Ramen5914/KiCadFiles/3dmodels/RamenKeebs.models/ATMEGA32U4-AUR.step

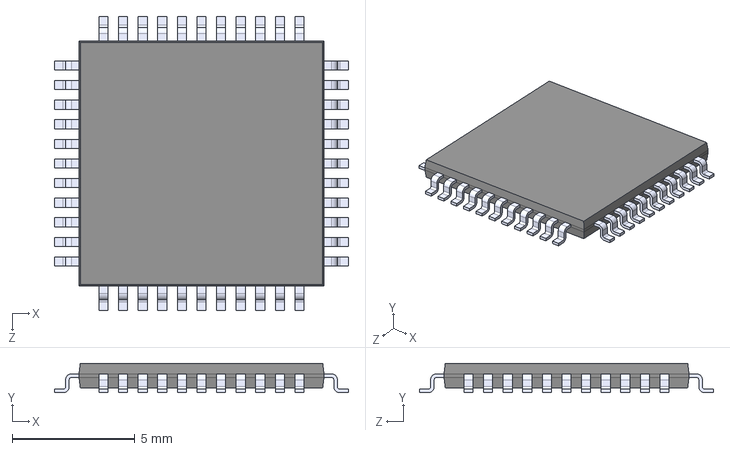
[picture p1: CAD file, 2022-03-06]
3dmodels/RamenKeebs.models/ATMEGA32U4-AUR.step
12.0 x 1.20 x 12.0 mm
