Ramen5914/KiCadFiles/3dmodels/RamenKeebs.models/USB4505-03-0-A.stp

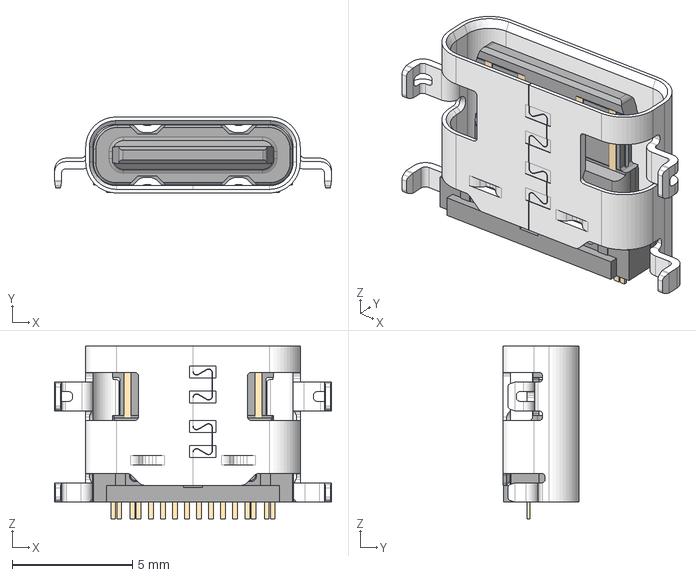
[picture p2: CAD file, 2022-03-06]
3dmodels/RamenKeebs.models/USB4505-03-0-A.stp
11.5 x 3.16 x 7.20 mm
Imported1
Cut-Extrude4
