Ramen5914/KiCadFiles/3dmodels/RamenKeebs.models/QBLP677R-RGB.step

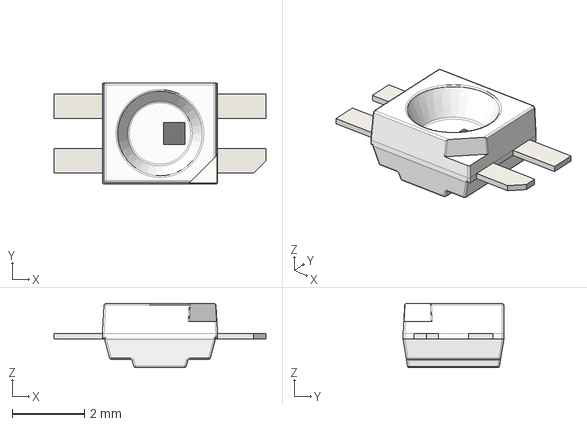
[picture p3: CAD file, 2022-03-06]
3dmodels/RamenKeebs.models/QBLP677R-RGB.step
5.88 x 2.80 x 1.78 mm
