Ramen5914/KiCadFiles/3dmodels/RamenKeebs.models/KAILH_PLATEMOUNT.step

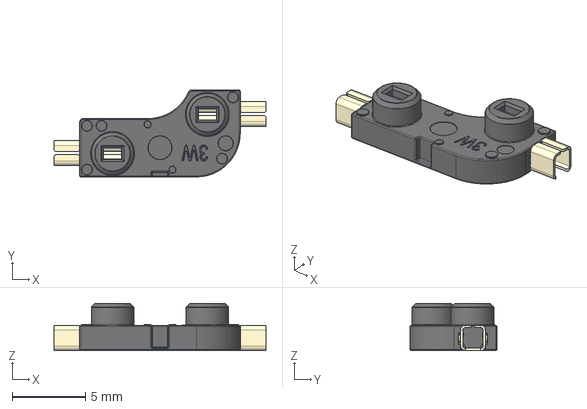
[picture p4: CAD file, 2022-03-06]
3dmodels/RamenKeebs.models/KAILH_PLATEMOUNT.step
14.5 x 5.95 x 3.22 mm
