Ramen5914/KiCadFiles/3dmodels/RamenKeebs.models/D_AXIAL.step

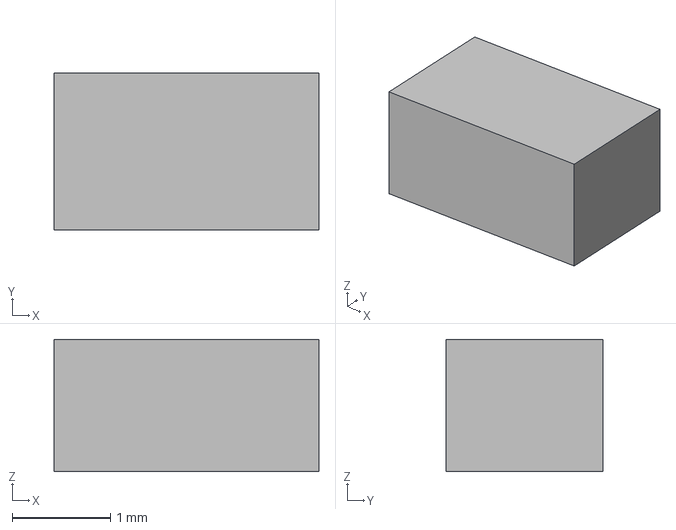
[picture p5: CAD file, 2022-02-28]
3dmodels/RamenKeebs.models/D_AXIAL.step
2.70 x 1.60 x 1.35 mm
