Ramen5914/KiCadFiles/(list of files, drawings)

Other design files:
projects/Ramen80/Ramen Board.dsn
