Ramen5914/KiCadFiles/projects/Ramen80/Ramen80.kicad_pcb

## KiCad design projects/Ramen80/Ramen80.kicad_pcb (2022-03-06)

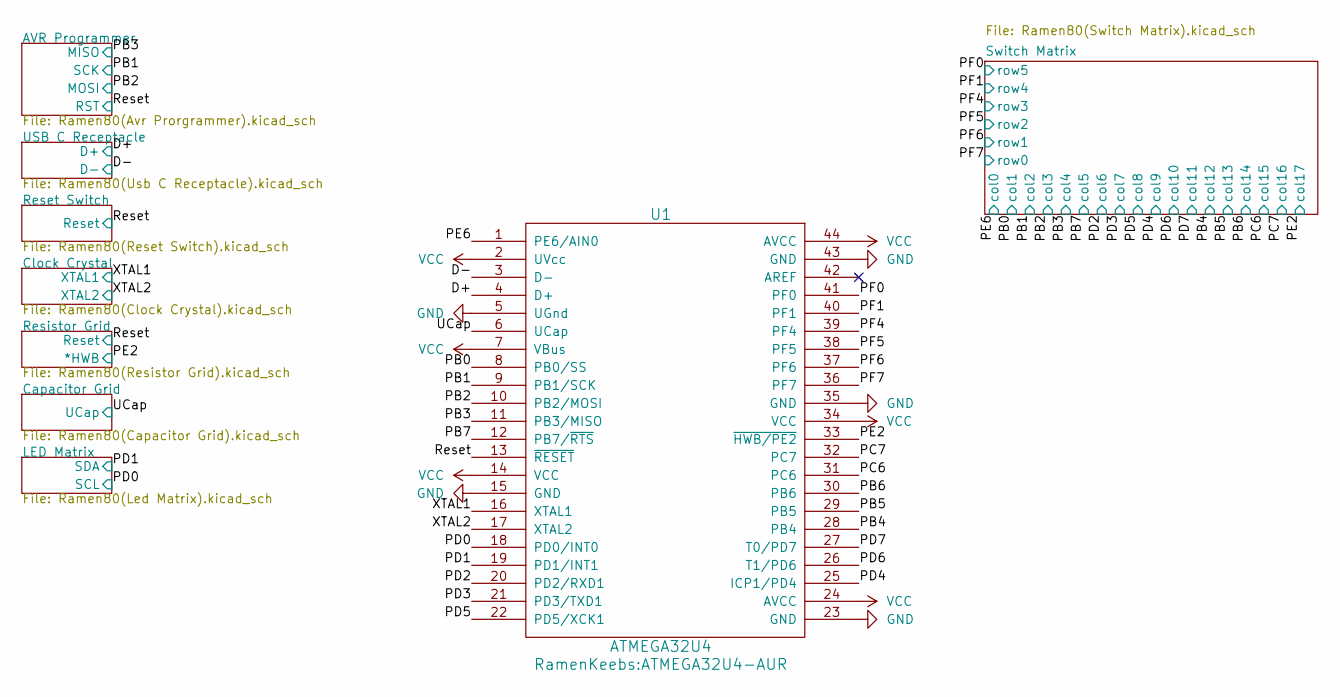
[picture p6: schematic Ramen80.kicad_sch]

Parts:
U1: ATMEGA32U4; ATMEGA32U4-AUR

Connections:
/D+: U1.4 (D+); also elsewhere on the board
/D-: U1.3 (D-); also elsewhere on the board
/PB0: U1.8 (PB0/SS); also elsewhere on the board
/PB1: U1.9 (PB1/SCK); also elsewhere on the board
/PB2: U1.10 (PB2/MOSI); also elsewhere on the board
/PB3: U1.11 (PB3/MISO); also elsewhere on the board
/PB4: U1.28 (PB4); also elsewhere on the board
/PB5: U1.29 (PB5); also elsewhere on the board
/PB6: U1.30 (PB6); also elsewhere on the board
/PB7: U1.12 (PB7/~RTS); also elsewhere on the board
/PC6: U1.31 (PC6); also elsewhere on the board
/PC7: U1.32 (PC7); also elsewhere on the board
/PD0: U1.18 (PD0/INT0); also elsewhere on the board
/PD1: U1.19 (PD1/INT1); also elsewhere on the board
/PD2: U1.20 (PD2/RXD1); also elsewhere on the board
/PD3: U1.21 (PD3/TXD1); also elsewhere on the board
/PD4: U1.25 (ICP1/PD4); also elsewhere on the board
/PD5: U1.22 (PD5/XCK1); also elsewhere on the board
/PD6: U1.26 (T1/PD6); also elsewhere on the board
/PD7: U1.27 (T0/PD7); also elsewhere on the board
/PE2: U1.33 (~HWB/PE2); also elsewhere on the board
/PE6: U1.1 (PE6/AIN0); also elsewhere on the board
/PF0: U1.41 (PF0); also elsewhere on the board
/PF1: U1.40 (PF1); also elsewhere on the board
/PF4: U1.39 (PF4); also elsewhere on the board
/PF5: U1.38 (PF5); also elsewhere on the board
/PF6: U1.37 (PF6); also elsewhere on the board
/PF7: U1.36 (PF7); also elsewhere on the board
/Reset: U1.13 (~RESET); also elsewhere on the board
/UCap: U1.6 (UCap); also elsewhere on the board
/XTAL1: U1.16 (XTAL1); also elsewhere on the board
/XTAL2: U1.17 (XTAL2); also elsewhere on the board
GND: U1.5 (UGnd), U1.15 (GND), U1.23 (GND), U1.35 (GND), U1.43 (GND); also elsewhere on the board
VCC: U1.2 (UVcc), U1.7 (VBus), U1.14 (VCC), U1.24 (AVCC), U1.34 (VCC), U1.44 (AVCC); also elsewhere on the board

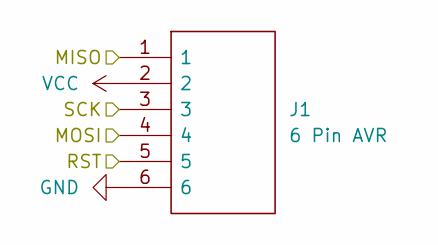
[picture p7: schematic Ramen80(Avr Prorgrammer).kicad_sch, Ramen80]

Parts:
J1: 6 Pin AVR; RHDR6W30P0X100_1X6_650X150X210P

Connections:
/PB1: J1.3; also elsewhere on the board
/PB2: J1.4; also elsewhere on the board
/PB3: J1.1; also elsewhere on the board
/Reset: J1.5; also elsewhere on the board
GND: J1.6; also elsewhere on the board
VCC: J1.2; also elsewhere on the board

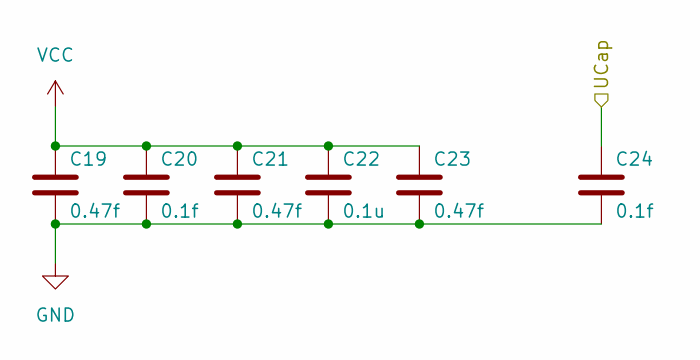
[picture p8: schematic Ramen80(Capacitor Grid).kicad_sch, Ramen80]

Parts:
C19, C21, C23: 0.47f; C_0805
C20, C24: 0.1f; C_0805
C22: 0.1u; C_0805

Connections:
/UCap: C24.1; also elsewhere on the board
GND: C19.2, C20.2, C21.2, C22.2, C23.2, C24.2; also elsewhere on the board
VCC: C19.1, C20.1, C21.1, C22.1, C23.1; also elsewhere on the board

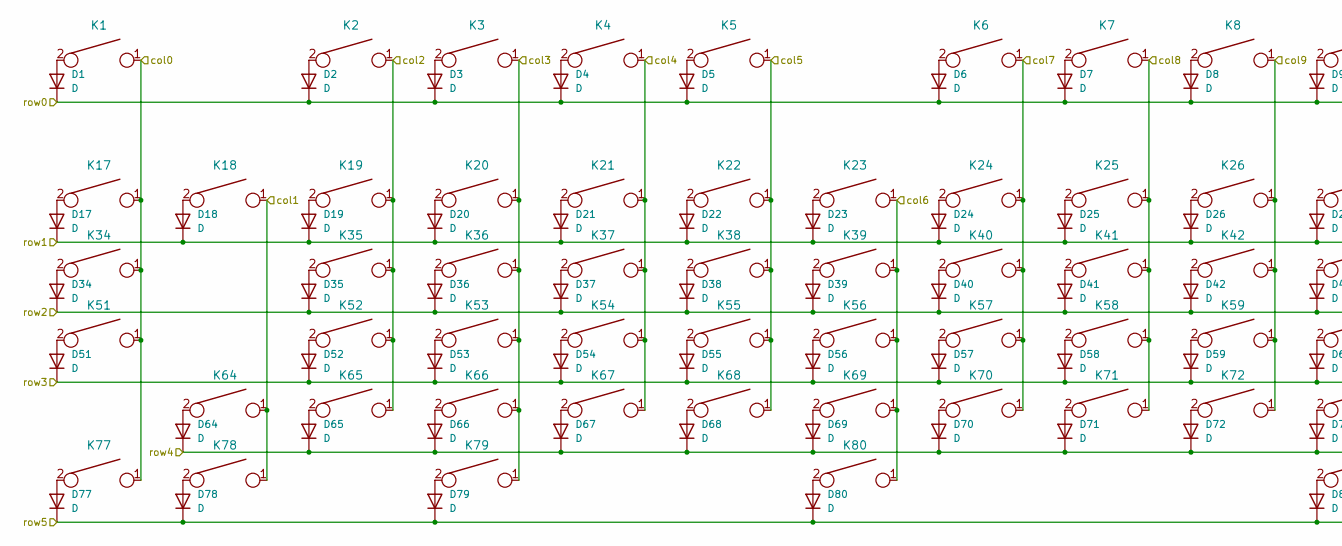
[picture p9: schematic Ramen80(Switch Matrix).kicad_sch, Ramen80, part in row 1, column 1]

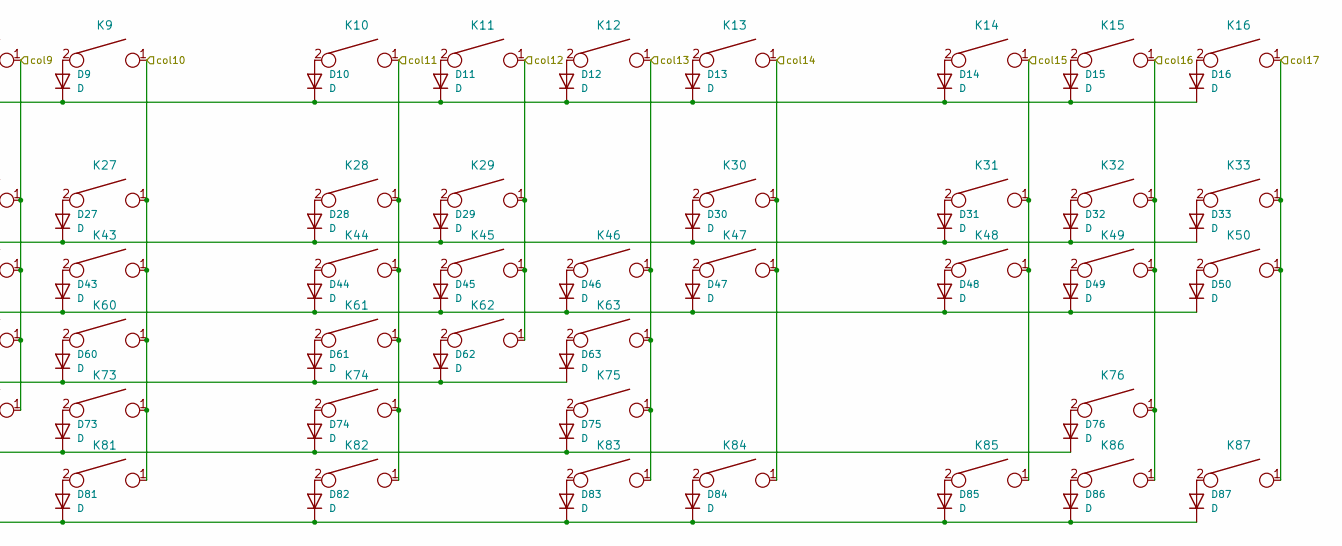
[picture p10: schematic Ramen80(Switch Matrix).kicad_sch, Ramen80, part in row 1, column 2]

Parts:
D1, D2, D3, D4, D5, D6, D7, D8, D9, D10, D11, D12, D13, D14, D15, D16, D17, D18, D19, D20, D21, D22, D23, D24, D25, D26, D27, D28, D29, D30, D31, D32, D33, D34, D35, D36, D37, D38, D39, D40, D41, D42, D43, D44, D45, D46, D47, D48, D49, D50, D51, D52, D53, D54, D55, D56, D57, D58, D59, D60, D61, D62, D63, D64, D65, D66, D67, D68, D69, D70, D71, D72, D73, D74, D75, D76, D77, D78, D79, D80, D81, D82, D83, D84, D85, D86, D87: D; D_AXIAL
K1, K2, K3, K4, K5, K6, K7, K8, K9, K10, K11, K12, K13, K14, K15, K16, K17, K18, K19, K20, K21, K22, K23, K24, K25, K26, K27, K28, K29, K30, K31, K32, K33, K34, K35, K36, K37, K38, K39, K40, K41, K42, K43, K44, K45, K46, K47, K48, K49, K50, K51, K52, K53, K54, K55, K56, K57, K58, K59, K60, K61, K62, K63, K64, K65, K66, K67, K68, K69, K70, K71, K72, K73, K74, K75, K76, K77, K78, K79, K80, K81, K82, K83, K84, K85, K86, K87: KEYSW; KAILH_PLATEMOUNT

Connections:
/PB0: K18.1, K64.1, K78.1; also elsewhere on the board
/PB1: K2.1, K19.1, K35.1, K52.1, K65.1; also elsewhere on the board
/PB2: K3.1, K20.1, K36.1, K53.1, K66.1, K79.1; also elsewhere on the board
/PB3: K4.1, K21.1, K37.1, K54.1, K67.1; also elsewhere on the board
/PB4: K11.1, K29.1, K45.1, K62.1; also elsewhere on the board
/PB5: K12.1, K46.1, K63.1, K75.1, K83.1; also elsewhere on the board
/PB6: K13.1, K30.1, K47.1, K84.1; also elsewhere on the board
/PB7: K5.1, K22.1, K38.1, K55.1, K68.1; also elsewhere on the board
/PC6: K14.1, K31.1, K48.1, K85.1; also elsewhere on the board
/PC7: K15.1, K32.1, K49.1, K76.1, K86.1; also elsewhere on the board
/PD2: K23.1, K39.1, K56.1, K69.1, K80.1; also elsewhere on the board
/PD3: K6.1, K24.1, K40.1, K57.1, K70.1; also elsewhere on the board
/PD4: K8.1, K26.1, K42.1, K59.1, K72.1; also elsewhere on the board
/PD5: K7.1, K25.1, K41.1, K58.1, K71.1; also elsewhere on the board
/PD6: K9.1, K27.1, K43.1, K60.1, K73.1, K81.1; also elsewhere on the board
/PD7: K10.1, K28.1, K44.1, K61.1, K74.1, K82.1; also elsewhere on the board
/PE2: K16.1, K33.1, K50.1, K87.1; also elsewhere on the board
/PE6: K1.1, K17.1, K34.1, K51.1, K77.1; also elsewhere on the board
/PF0: D77.1 (K), D78.1 (K), D79.1 (K), D80.1 (K), D81.1 (K), D82.1 (K), D83.1 (K), D84.1 (K), D85.1 (K), D86.1 (K), D87.1 (K); also elsewhere on the board
/PF1: D64.1 (K), D65.1 (K), D66.1 (K), D67.1 (K), D68.1 (K), D69.1 (K), D70.1 (K), D71.1 (K), D72.1 (K), D73.1 (K), D74.1 (K), D75.1 (K), D76.1 (K); also elsewhere on the board
/PF4: D51.1 (K), D52.1 (K), D53.1 (K), D54.1 (K), D55.1 (K), D56.1 (K), D57.1 (K), D58.1 (K), D59.1 (K), D60.1 (K), D61.1 (K), D62.1 (K), D63.1 (K); also elsewhere on the board
/PF5: D34.1 (K), D35.1 (K), D36.1 (K), D37.1 (K), D38.1 (K), D39.1 (K), D40.1 (K), D41.1 (K), D42.1 (K), D43.1 (K), D44.1 (K), D45.1 (K), D46.1 (K), D47.1 (K), D48.1 (K), D49.1 (K), D50.1 (K); also elsewhere on the board
/PF6: D17.1 (K), D18.1 (K), D19.1 (K), D20.1 (K), D21.1 (K), D22.1 (K), D23.1 (K), D24.1 (K), D25.1 (K), D26.1 (K), D27.1 (K), D28.1 (K), D29.1 (K), D30.1 (K), D31.1 (K), D32.1 (K), D33.1 (K); also elsewhere on the board
/PF7: D1.1 (K), D2.1 (K), D3.1 (K), D4.1 (K), D5.1 (K), D6.1 (K), D7.1 (K), D8.1 (K), D9.1 (K), D10.1 (K), D11.1 (K), D12.1 (K), D13.1 (K), D14.1 (K), D15.1 (K), D16.1 (K); also elsewhere on the board
unnamed: D1.2 (A), K1.2
unnamed: D2.2 (A), K2.2
unnamed: D3.2 (A), K3.2
unnamed: D4.2 (A), K4.2
unnamed: D5.2 (A), K5.2
unnamed: D6.2 (A), K6.2
unnamed: D7.2 (A), K7.2
unnamed: D8.2 (A), K8.2
unnamed: D9.2 (A), K9.2
unnamed: D10.2 (A), K10.2
unnamed: D11.2 (A), K11.2
unnamed: D12.2 (A), K12.2
unnamed: D13.2 (A), K13.2
unnamed: D14.2 (A), K14.2
unnamed: D15.2 (A), K15.2
unnamed: D16.2 (A), K16.2
unnamed: D17.2 (A), K17.2
unnamed: D18.2 (A), K18.2
unnamed: D19.2 (A), K19.2
unnamed: D20.2 (A), K20.2
unnamed: D21.2 (A), K21.2
unnamed: D22.2 (A), K22.2
unnamed: D23.2 (A), K23.2
unnamed: D24.2 (A), K24.2
unnamed: D25.2 (A), K25.2
unnamed: D26.2 (A), K26.2
unnamed: D27.2 (A), K27.2
unnamed: D28.2 (A), K28.2
unnamed: D29.2 (A), K29.2
unnamed: D30.2 (A), K30.2
unnamed: D31.2 (A), K31.2
unnamed: D32.2 (A), K32.2
unnamed: D33.2 (A), K33.2
unnamed: D34.2 (A), K34.2
unnamed: D35.2 (A), K35.2
unnamed: D36.2 (A), K36.2
unnamed: D37.2 (A), K37.2
unnamed: D38.2 (A), K38.2
unnamed: D39.2 (A), K39.2
unnamed: D40.2 (A), K40.2
unnamed: D41.2 (A), K41.2
unnamed: D42.2 (A), K42.2
unnamed: D43.2 (A), K43.2
unnamed: D44.2 (A), K44.2
unnamed: D45.2 (A), K45.2
unnamed: D46.2 (A), K46.2
unnamed: D47.2 (A), K47.2
unnamed: D48.2 (A), K48.2
unnamed: D49.2 (A), K49.2
unnamed: D50.2 (A), K50.2
unnamed: D51.2 (A), K51.2
unnamed: D52.2 (A), K52.2
unnamed: D53.2 (A), K53.2
unnamed: D54.2 (A), K54.2
unnamed: D55.2 (A), K55.2
unnamed: D56.2 (A), K56.2
unnamed: D57.2 (A), K57.2
unnamed: D58.2 (A), K58.2
unnamed: D59.2 (A), K59.2
unnamed: D60.2 (A), K60.2
unnamed: D61.2 (A), K61.2
unnamed: D62.2 (A), K62.2
unnamed: D63.2 (A), K63.2
unnamed: D64.2 (A), K64.2
unnamed: D65.2 (A), K65.2
unnamed: D66.2 (A), K66.2
unnamed: D67.2 (A), K67.2
unnamed: D68.2 (A), K68.2
unnamed: D69.2 (A), K69.2
unnamed: D70.2 (A), K70.2
unnamed: D71.2 (A), K71.2
unnamed: D72.2 (A), K72.2
unnamed: D73.2 (A), K73.2
unnamed: D74.2 (A), K74.2
unnamed: D75.2 (A), K75.2
unnamed: D76.2 (A), K76.2
unnamed: D77.2 (A), K77.2
unnamed: D78.2 (A), K78.2
unnamed: D79.2 (A), K79.2
unnamed: D80.2 (A), K80.2
unnamed: D81.2 (A), K81.2
unnamed: D82.2 (A), K82.2
unnamed: D83.2 (A), K83.2
unnamed: D84.2 (A), K84.2
unnamed: D85.2 (A), K85.2
unnamed: D86.2 (A), K86.2
unnamed: D87.2 (A), K87.2

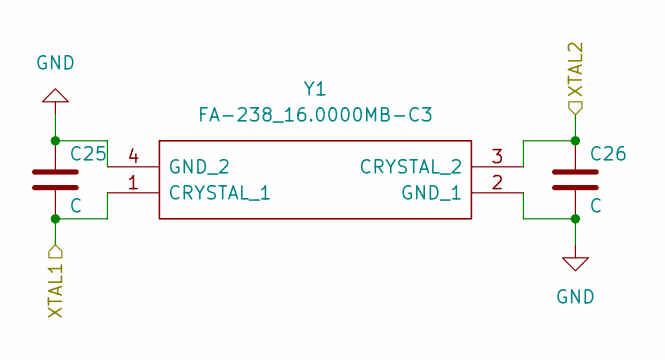
[picture p11: schematic Ramen80(Clock Crystal).kicad_sch, Ramen80]

Parts:
C25, C26: C; C_0805
Y1: FA-238_16.0000MB-C3; FA238160000MBC3; Manufacturer_Part_Number FA-238 16.0000MB-C3; Mouser Part Number 732-FA-23816B-C3

Connections:
/XTAL1: C25.2, Y1.1 (CRYSTAL_1); also elsewhere on the board
/XTAL2: C26.1, Y1.3 (CRYSTAL_2); also elsewhere on the board
GND: C25.1, C26.2, Y1.2 (GND_1), Y1.4 (GND_2); also elsewhere on the board

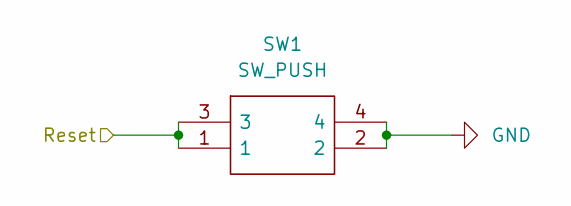
[picture p12: schematic Ramen80(Reset Switch).kicad_sch, Ramen80]

Parts:
SW1: SW_PUSH; TL3342F160QG

Connections:
/Reset: SW1.1, SW1.3; also elsewhere on the board
GND: SW1.2, SW1.4; also elsewhere on the board

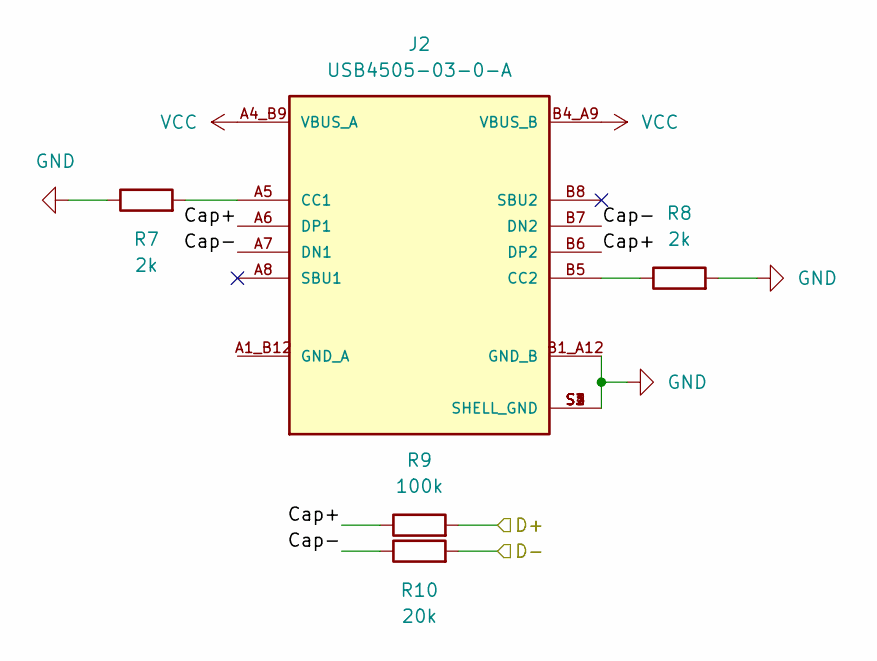
[picture p13: schematic Ramen80(Usb C Receptacle).kicad_sch, Ramen80]

Parts:
J2: USB4505-03-0-A
R7, R8: 2k; R_0805
R9: 100k; R_0805
R10: 20k; R_0805

Connections:
/D+: R9.2; also elsewhere on the board
/D-: R10.2; also elsewhere on the board
/USB C Receptacle/Cap+: J2.A6 (DP1), J2.B6 (DP2), R9.1
/USB C Receptacle/Cap-: J2.A7 (DN1), J2.B7 (DN2), R10.1
GND: J2.B1_A12 (GND_B), J2.S1 (SHELL_GND), J2.S2 (SHELL_GND), J2.S3 (SHELL_GND), J2.S4 (SHELL_GND), R7.1, R8.2; also elsewhere on the board
unnamed: J2.A5 (CC1), R7.2
unnamed: J2.B5 (CC2), R8.1
VCC: J2.A4_B9 (VBUS_A), J2.B4_A9 (VBUS_B); also elsewhere on the board

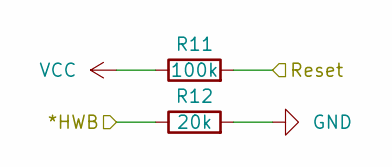
[picture p14: schematic Ramen80(Resistor Grid).kicad_sch, Ramen80]

Parts:
R11: 100k; R_0805
R12: 20k; R_0805

Connections:
/PE2: R12.1; also elsewhere on the board
/Reset: R11.2; also elsewhere on the board
GND: R12.2; also elsewhere on the board
VCC: R11.1; also elsewhere on the board

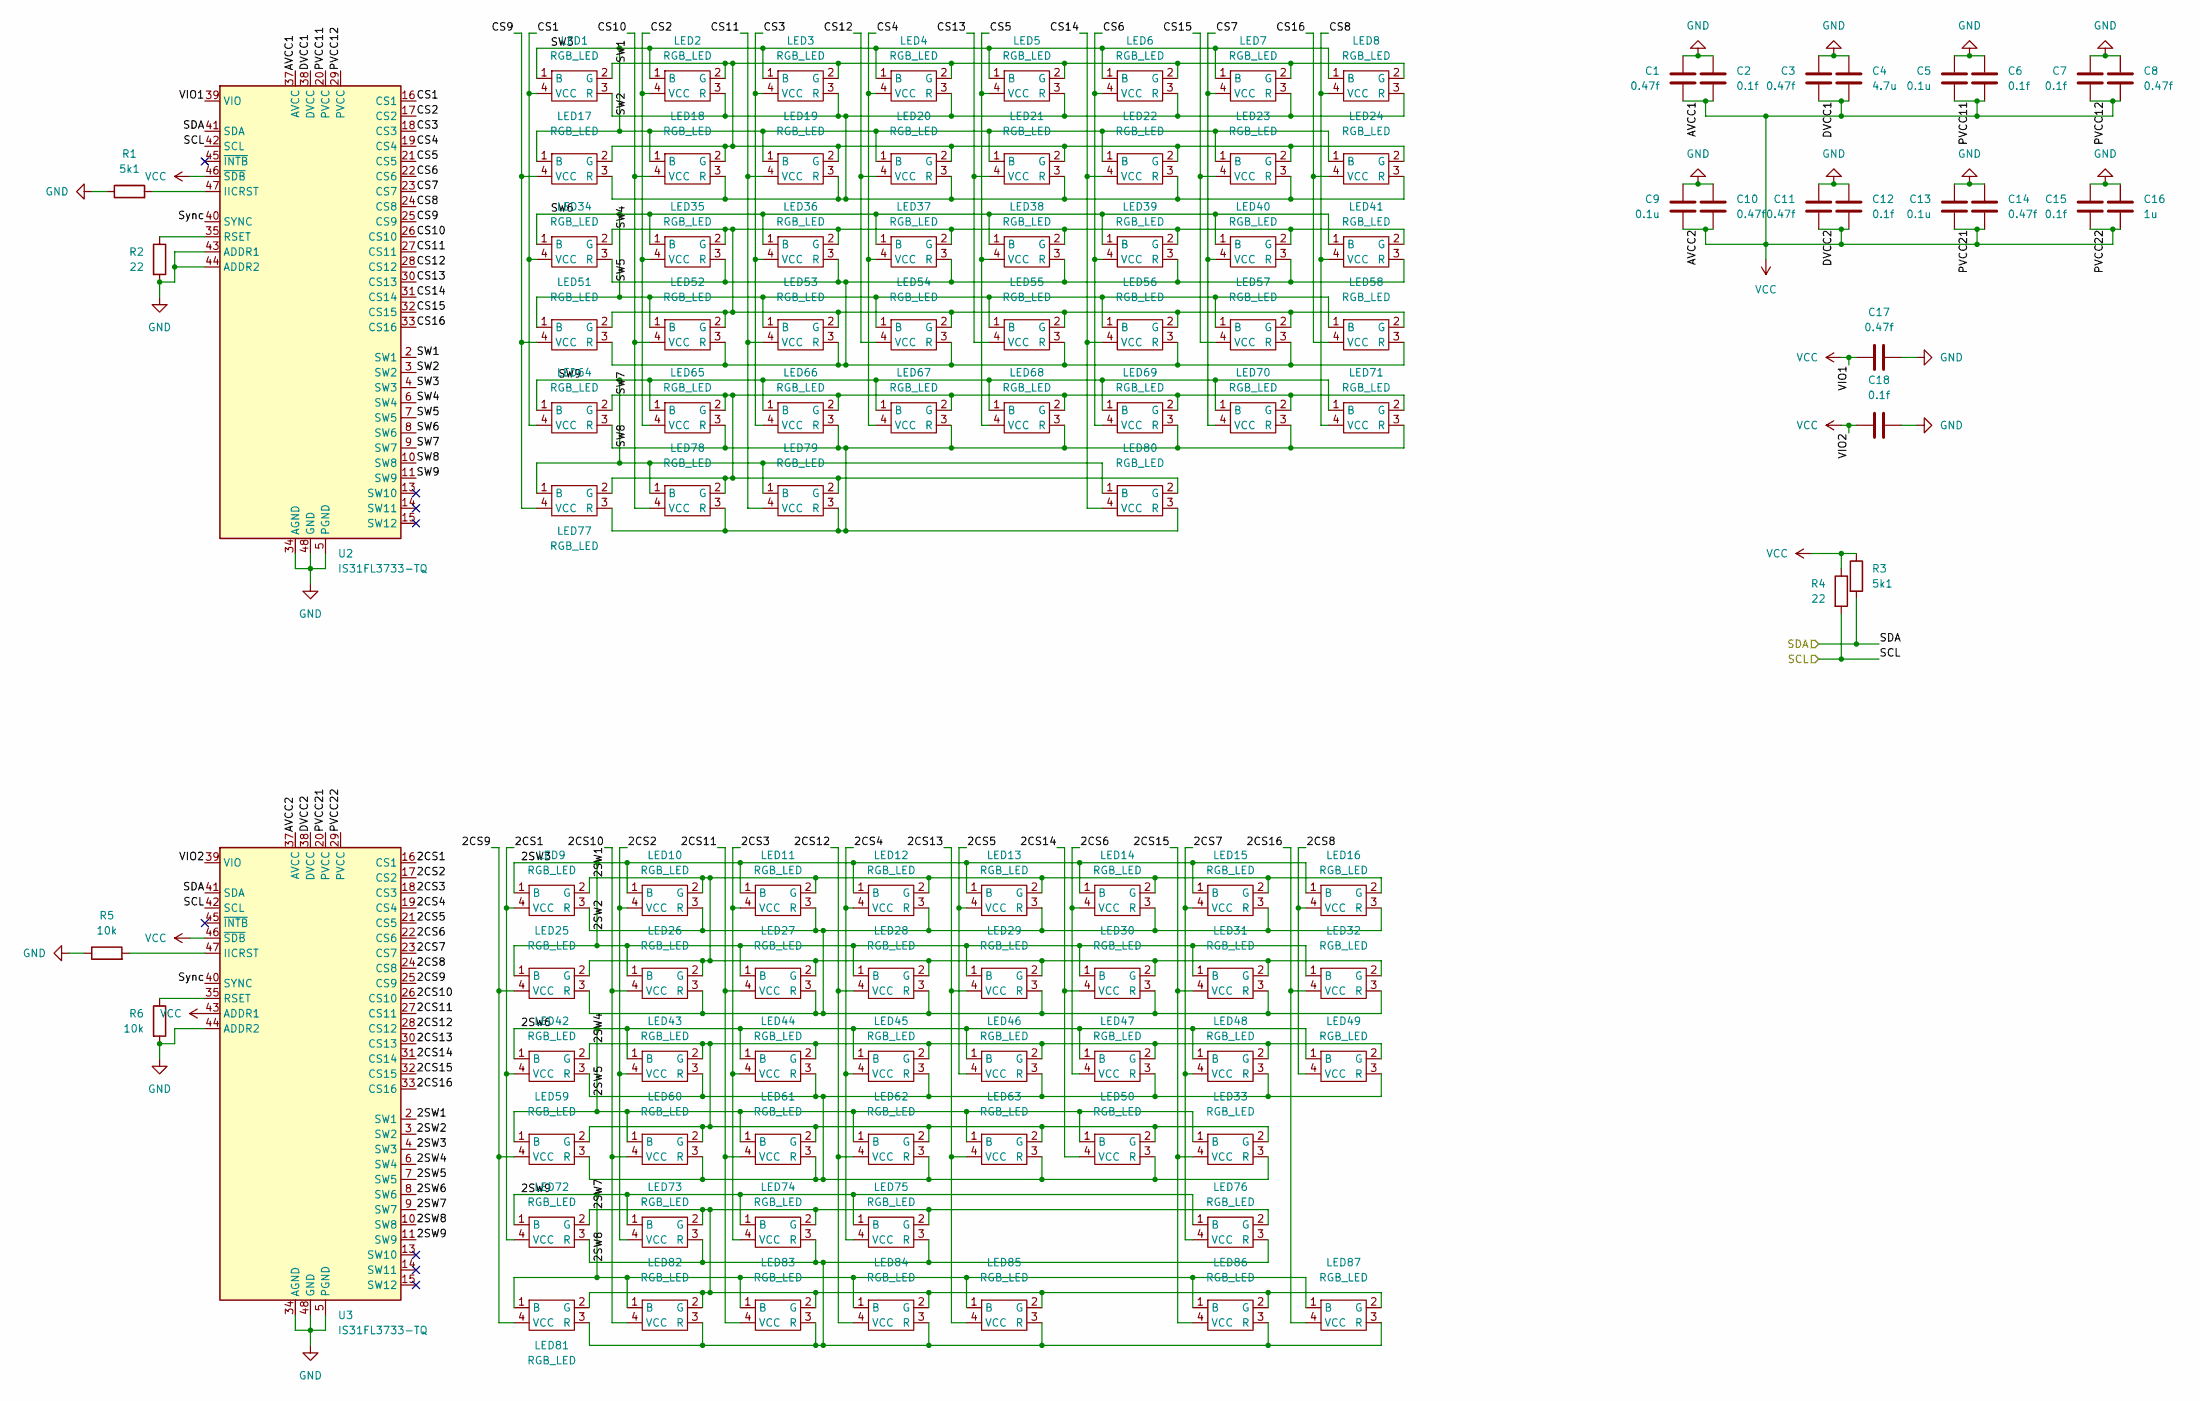
[picture p15: schematic Ramen80(Led Matrix).kicad_sch, Ramen80]

Parts:
C1, C3, C8, C10, C11, C14, C17: 0.47f; C_0805
C2, C6, C7, C12, C15, C18: 0.1f; C_0805
C4: 4.7u; C_0805
C5, C9, C13: 0.1u; C_0805
C16: 1u; C_0805
LED1, LED2, LED3, LED4, LED5, LED6, LED7, LED8, LED9, LED10, LED11, LED12, LED13, LED14, LED15, LED16, LED17, LED18, LED19, LED20, LED21, LED22, LED23, LED24, LED25, LED26, LED27, LED28, LED29, LED30, LED31, LED32, LED33, LED34, LED35, LED36, LED37, LED38, LED39, LED40, LED41, LED42, LED43, LED44, LED45, LED46, LED47, LED48, LED49, LED50, LED51, LED52, LED53, LED54, LED55, LED56, LED57, LED58, LED59, LED60, LED61, LED62, LED63, LED64, LED65, LED66, LED67, LED68, LED69, LED70, LED71, LED72, LED73, LED74, LED75, LED76, LED77, LED78, LED79, LED80, LED81, LED82, LED83, LED84, LED85, LED86, LED87: RGB_LED; QBLP677R-RGB
R1, R3: 5k1; R_0805
R2, R4: 22; R_0805
R5, R6: 10k; R_0805
U2, U3: IS31FL3733-TQ; TQFP-48-1EP_7x7mm_P0.5mm_EP5x5mm

Connections:
/LED Matrix/2CS1: LED9.4 (VCC), LED42.4 (VCC), LED72.4 (VCC), U3.16 (CS1)
/LED Matrix/2CS2: LED10.4 (VCC), LED43.4 (VCC), LED73.4 (VCC), U3.17 (CS2)
/LED Matrix/2CS3: LED11.4 (VCC), LED44.4 (VCC), LED74.4 (VCC), U3.18 (CS3)
/LED Matrix/2CS4: LED12.4 (VCC), LED45.4 (VCC), LED75.4 (VCC), U3.19 (CS4)
/LED Matrix/2CS5: LED13.4 (VCC), LED46.4 (VCC), U3.21 (CS5)
/LED Matrix/2CS6: LED14.4 (VCC), LED47.4 (VCC), U3.22 (CS6)
/LED Matrix/2CS7: LED15.4 (VCC), LED48.4 (VCC), LED76.4 (VCC), U3.23 (CS7)
/LED Matrix/2CS8: LED16.4 (VCC), LED49.4 (VCC), U3.24 (CS8)
/LED Matrix/2CS9: LED25.4 (VCC), LED59.4 (VCC), LED81.4 (VCC), U3.25 (CS9)
/LED Matrix/2CS10: LED26.4 (VCC), LED60.4 (VCC), LED82.4 (VCC), U3.26 (CS10)
/LED Matrix/2CS11: LED27.4 (VCC), LED61.4 (VCC), LED83.4 (VCC), U3.27 (CS11)
/LED Matrix/2CS12: LED28.4 (VCC), LED62.4 (VCC), LED84.4 (VCC), U3.28 (CS12)
/LED Matrix/2CS13: LED29.4 (VCC), LED63.4 (VCC), LED85.4 (VCC), U3.30 (CS13)
/LED Matrix/2CS14: LED30.4 (VCC), LED50.4 (VCC), U3.31 (CS14)
/LED Matrix/2CS15: LED31.4 (VCC), LED33.4 (VCC), LED86.4 (VCC), U3.32 (CS15)
/LED Matrix/2CS16: LED32.4 (VCC), LED87.4 (VCC), U3.33 (CS16)
/LED Matrix/2SW1: LED9.2 (G), LED10.2 (G), LED11.2 (G), LED12.2 (G), LED13.2 (G), LED14.2 (G), LED15.2 (G), LED16.2 (G), LED25.2 (G), LED26.2 (G), LED27.2 (G), LED28.2 (G), LED29.2 (G), LED30.2 (G), LED31.2 (G), LED32.2 (G), U3.2 (SW1)
/LED Matrix/2SW2: LED9.3 (R), LED10.3 (R), LED11.3 (R), LED12.3 (R), LED13.3 (R), LED14.3 (R), LED15.3 (R), LED16.3 (R), LED25.3 (R), LED26.3 (R), LED27.3 (R), LED28.3 (R), LED29.3 (R), LED30.3 (R), LED31.3 (R), LED32.3 (R), U3.3 (SW2)
/LED Matrix/2SW3: LED9.1 (B), LED10.1 (B), LED11.1 (B), LED12.1 (B), LED13.1 (B), LED14.1 (B), LED15.1 (B), LED16.1 (B), LED25.1 (B), LED26.1 (B), LED27.1 (B), LED28.1 (B), LED29.1 (B), LED30.1 (B), LED31.1 (B), LED32.1 (B), U3.4 (SW3)
/LED Matrix/2SW4: LED33.2 (G), LED42.2 (G), LED43.2 (G), LED44.2 (G), LED45.2 (G), LED46.2 (G), LED47.2 (G), LED48.2 (G), LED49.2 (G), LED50.2 (G), LED59.2 (G), LED60.2 (G), LED61.2 (G), LED62.2 (G), LED63.2 (G), U3.6 (SW4)
/LED Matrix/2SW5: LED33.3 (R), LED42.3 (R), LED43.3 (R), LED44.3 (R), LED45.3 (R), LED46.3 (R), LED47.3 (R), LED48.3 (R), LED49.3 (R), LED50.3 (R), LED59.3 (R), LED60.3 (R), LED61.3 (R), LED62.3 (R), LED63.3 (R), U3.7 (SW5)
/LED Matrix/2SW6: LED33.1 (B), LED42.1 (B), LED43.1 (B), LED44.1 (B), LED45.1 (B), LED46.1 (B), LED47.1 (B), LED48.1 (B), LED49.1 (B), LED50.1 (B), LED59.1 (B), LED60.1 (B), LED61.1 (B), LED62.1 (B), LED63.1 (B), U3.8 (SW6)
/LED Matrix/2SW7: LED72.2 (G), LED73.2 (G), LED74.2 (G), LED75.2 (G), LED76.2 (G), LED81.2 (G), LED82.2 (G), LED83.2 (G), LED84.2 (G), LED85.2 (G), LED86.2 (G), LED87.2 (G), U3.9 (SW7)
/LED Matrix/2SW8: LED72.3 (R), LED73.3 (R), LED74.3 (R), LED75.3 (R), LED76.3 (R), LED81.3 (R), LED82.3 (R), LED83.3 (R), LED84.3 (R), LED85.3 (R), LED86.3 (R), LED87.3 (R), U3.10 (SW8)
/LED Matrix/2SW9: LED72.1 (B), LED73.1 (B), LED74.1 (B), LED75.1 (B), LED76.1 (B), LED81.1 (B), LED82.1 (B), LED83.1 (B), LED84.1 (B), LED85.1 (B), LED86.1 (B), LED87.1 (B), U3.11 (SW9)
/LED Matrix/CS1: LED1.4 (VCC), LED34.4 (VCC), LED64.4 (VCC), U2.16 (CS1)
/LED Matrix/CS2: LED2.4 (VCC), LED35.4 (VCC), LED65.4 (VCC), U2.17 (CS2)
/LED Matrix/CS3: LED3.4 (VCC), LED36.4 (VCC), LED66.4 (VCC), U2.18 (CS3)
/LED Matrix/CS4: LED4.4 (VCC), LED37.4 (VCC), LED67.4 (VCC), U2.19 (CS4)
/LED Matrix/CS5: LED5.4 (VCC), LED38.4 (VCC), LED68.4 (VCC), U2.21 (CS5)
/LED Matrix/CS6: LED6.4 (VCC), LED39.4 (VCC), LED69.4 (VCC), U2.22 (CS6)
/LED Matrix/CS7: LED7.4 (VCC), LED40.4 (VCC), LED70.4 (VCC), U2.23 (CS7)
/LED Matrix/CS8: LED8.4 (VCC), LED41.4 (VCC), LED71.4 (VCC), U2.24 (CS8)
/LED Matrix/CS9: LED17.4 (VCC), LED51.4 (VCC), LED77.4 (VCC), U2.25 (CS9)
/LED Matrix/CS10: LED18.4 (VCC), LED52.4 (VCC), LED78.4 (VCC), U2.26 (CS10)
/LED Matrix/CS11: LED19.4 (VCC), LED53.4 (VCC), LED79.4 (VCC), U2.27 (CS11)
/LED Matrix/CS12: LED20.4 (VCC), LED54.4 (VCC), U2.28 (CS12)
/LED Matrix/CS13: LED21.4 (VCC), LED55.4 (VCC), U2.30 (CS13)
/LED Matrix/CS14: LED22.4 (VCC), LED56.4 (VCC), LED80.4 (VCC), U2.31 (CS14)
/LED Matrix/CS15: LED23.4 (VCC), LED57.4 (VCC), U2.32 (CS15)
/LED Matrix/CS16: LED24.4 (VCC), LED58.4 (VCC), U2.33 (CS16)
/LED Matrix/SW1: LED1.2 (G), LED2.2 (G), LED3.2 (G), LED4.2 (G), LED5.2 (G), LED6.2 (G), LED7.2 (G), LED8.2 (G), LED17.2 (G), LED18.2 (G), LED19.2 (G), LED20.2 (G), LED21.2 (G), LED22.2 (G), LED23.2 (G), LED24.2 (G), U2.2 (SW1)
/LED Matrix/SW2: LED1.3 (R), LED2.3 (R), LED3.3 (R), LED4.3 (R), LED5.3 (R), LED6.3 (R), LED7.3 (R), LED8.3 (R), LED17.3 (R), LED18.3 (R), LED19.3 (R), LED20.3 (R), LED21.3 (R), LED22.3 (R), LED23.3 (R), LED24.3 (R), U2.3 (SW2)
/LED Matrix/SW3: LED1.1 (B), LED2.1 (B), LED3.1 (B), LED4.1 (B), LED5.1 (B), LED6.1 (B), LED7.1 (B), LED8.1 (B), LED17.1 (B), LED18.1 (B), LED19.1 (B), LED20.1 (B), LED21.1 (B), LED22.1 (B), LED23.1 (B), LED24.1 (B), U2.4 (SW3)
/LED Matrix/SW4: LED34.2 (G), LED35.2 (G), LED36.2 (G), LED37.2 (G), LED38.2 (G), LED39.2 (G), LED40.2 (G), LED41.2 (G), LED51.2 (G), LED52.2 (G), LED53.2 (G), LED54.2 (G), LED55.2 (G), LED56.2 (G), LED57.2 (G), LED58.2 (G), U2.6 (SW4)
/LED Matrix/SW5: LED34.3 (R), LED35.3 (R), LED36.3 (R), LED37.3 (R), LED38.3 (R), LED39.3 (R), LED40.3 (R), LED41.3 (R), LED51.3 (R), LED52.3 (R), LED53.3 (R), LED54.3 (R), LED55.3 (R), LED56.3 (R), LED57.3 (R), LED58.3 (R), U2.7 (SW5)
/LED Matrix/SW6: LED34.1 (B), LED35.1 (B), LED36.1 (B), LED37.1 (B), LED38.1 (B), LED39.1 (B), LED40.1 (B), LED41.1 (B), LED51.1 (B), LED52.1 (B), LED53.1 (B), LED54.1 (B), LED55.1 (B), LED56.1 (B), LED57.1 (B), LED58.1 (B), U2.8 (SW6)
/LED Matrix/SW7: LED64.2 (G), LED65.2 (G), LED66.2 (G), LED67.2 (G), LED68.2 (G), LED69.2 (G), LED70.2 (G), LED71.2 (G), LED77.2 (G), LED78.2 (G), LED79.2 (G), LED80.2 (G), U2.9 (SW7)
/LED Matrix/SW8: LED64.3 (R), LED65.3 (R), LED66.3 (R), LED67.3 (R), LED68.3 (R), LED69.3 (R), LED70.3 (R), LED71.3 (R), LED77.3 (R), LED78.3 (R), LED79.3 (R), LED80.3 (R), U2.10 (SW8)
/LED Matrix/SW9: LED64.1 (B), LED65.1 (B), LED66.1 (B), LED67.1 (B), LED68.1 (B), LED69.1 (B), LED70.1 (B), LED71.1 (B), LED77.1 (B), LED78.1 (B), LED79.1 (B), LED80.1 (B), U2.11 (SW9)
/LED Matrix/Sync: U2.40 (SYNC), U3.40 (SYNC)
/PD0: R4.2, U2.42 (SCL), U3.42 (SCL); also elsewhere on the board
/PD1: R3.2, U2.41 (SDA), U3.41 (SDA); also elsewhere on the board
GND: C1.2, C2.2, C3.2, C4.2, C5.2, C6.2, C7.2, C8.2, C9.2, C10.2, C11.2, C12.2, C13.2, C14.2, C15.2, C16.2, C17.2, C18.2, R1.1, R2.2, R5.1, R6.2, U2.5 (PGND), U2.12 (PGND), U2.34 (AGND), U2.43 (ADDR1), U2.44 (ADDR2), U2.48 (GND), U2.49 (GND), U3.5 (PGND), U3.12 (PGND), U3.34 (AGND), U3.44 (ADDR2), U3.48 (GND), U3.49 (GND); also elsewhere on the board
unnamed: R1.2, U2.47 (IICRST)
unnamed: R2.1, U2.35 (RSET)
unnamed: R5.2, U3.47 (IICRST)
unnamed: R6.1, U3.35 (RSET)
VCC: C1.1, C2.1, C3.1, C4.1, C5.1, C6.1, C7.1, C8.1, C9.1, C10.1, C11.1, C12.1, C13.1, C14.1, C15.1, C16.1, C17.1, C18.1, R3.1, R4.1, U2.20 (PVCC), U2.29 (PVCC), U2.37 (AVCC), U2.38 (DVCC), U2.39 (VIO), U2.46 (~SDB), U3.20 (PVCC), U3.29 (PVCC), U3.37 (AVCC), U3.38 (DVCC), U3.39 (VIO), U3.43 (ADDR1), U3.46 (~SDB); also elsewhere on the board

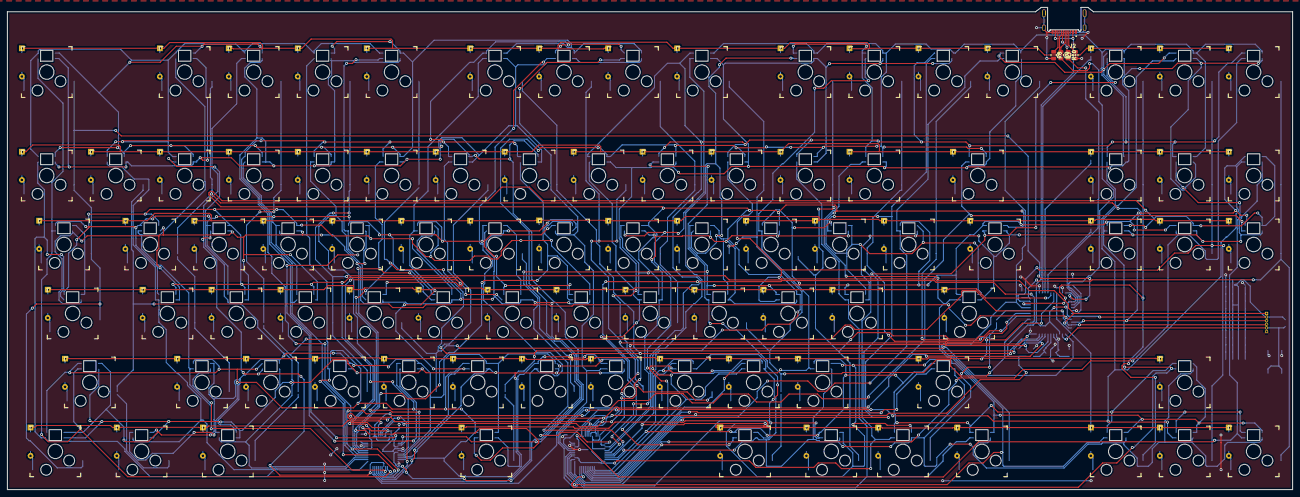
[picture p16: board Ramen80.kicad_pcb from above]

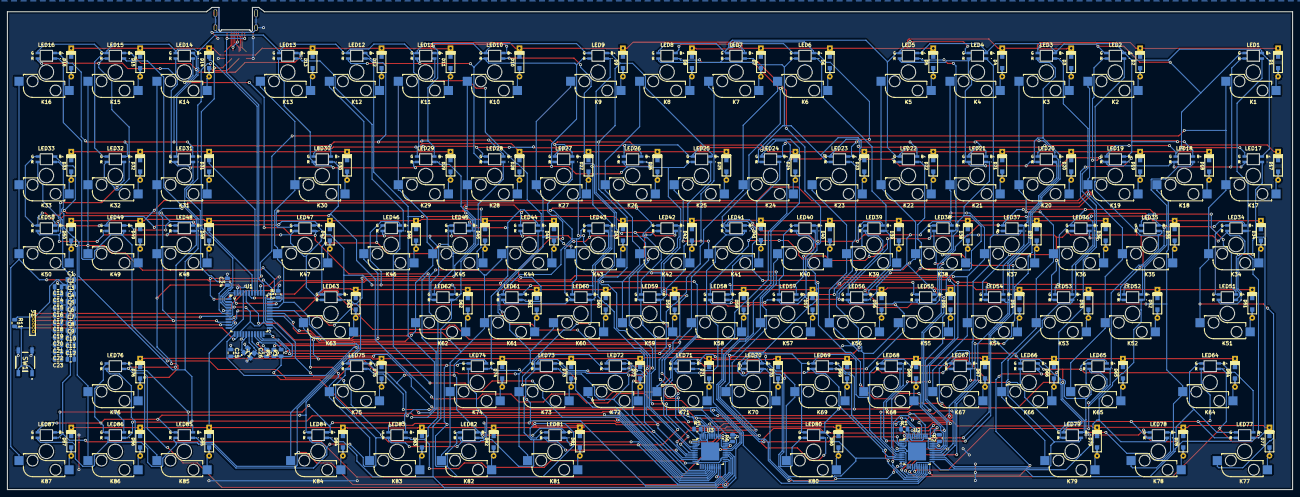
[picture p17: board Ramen80.kicad_pcb from below]

Board: 2 copper layers, 355.0 x 133.2 mm, 306 parts (214 on the bottom side), 180 nets.
