Ramen5914/KiCadFiles/projects/Ramen Pad/Ramen Pad.kicad_pcb

## KiCad design projects/Ramen Pad/Ramen Pad.kicad_pcb (2022-02-28)

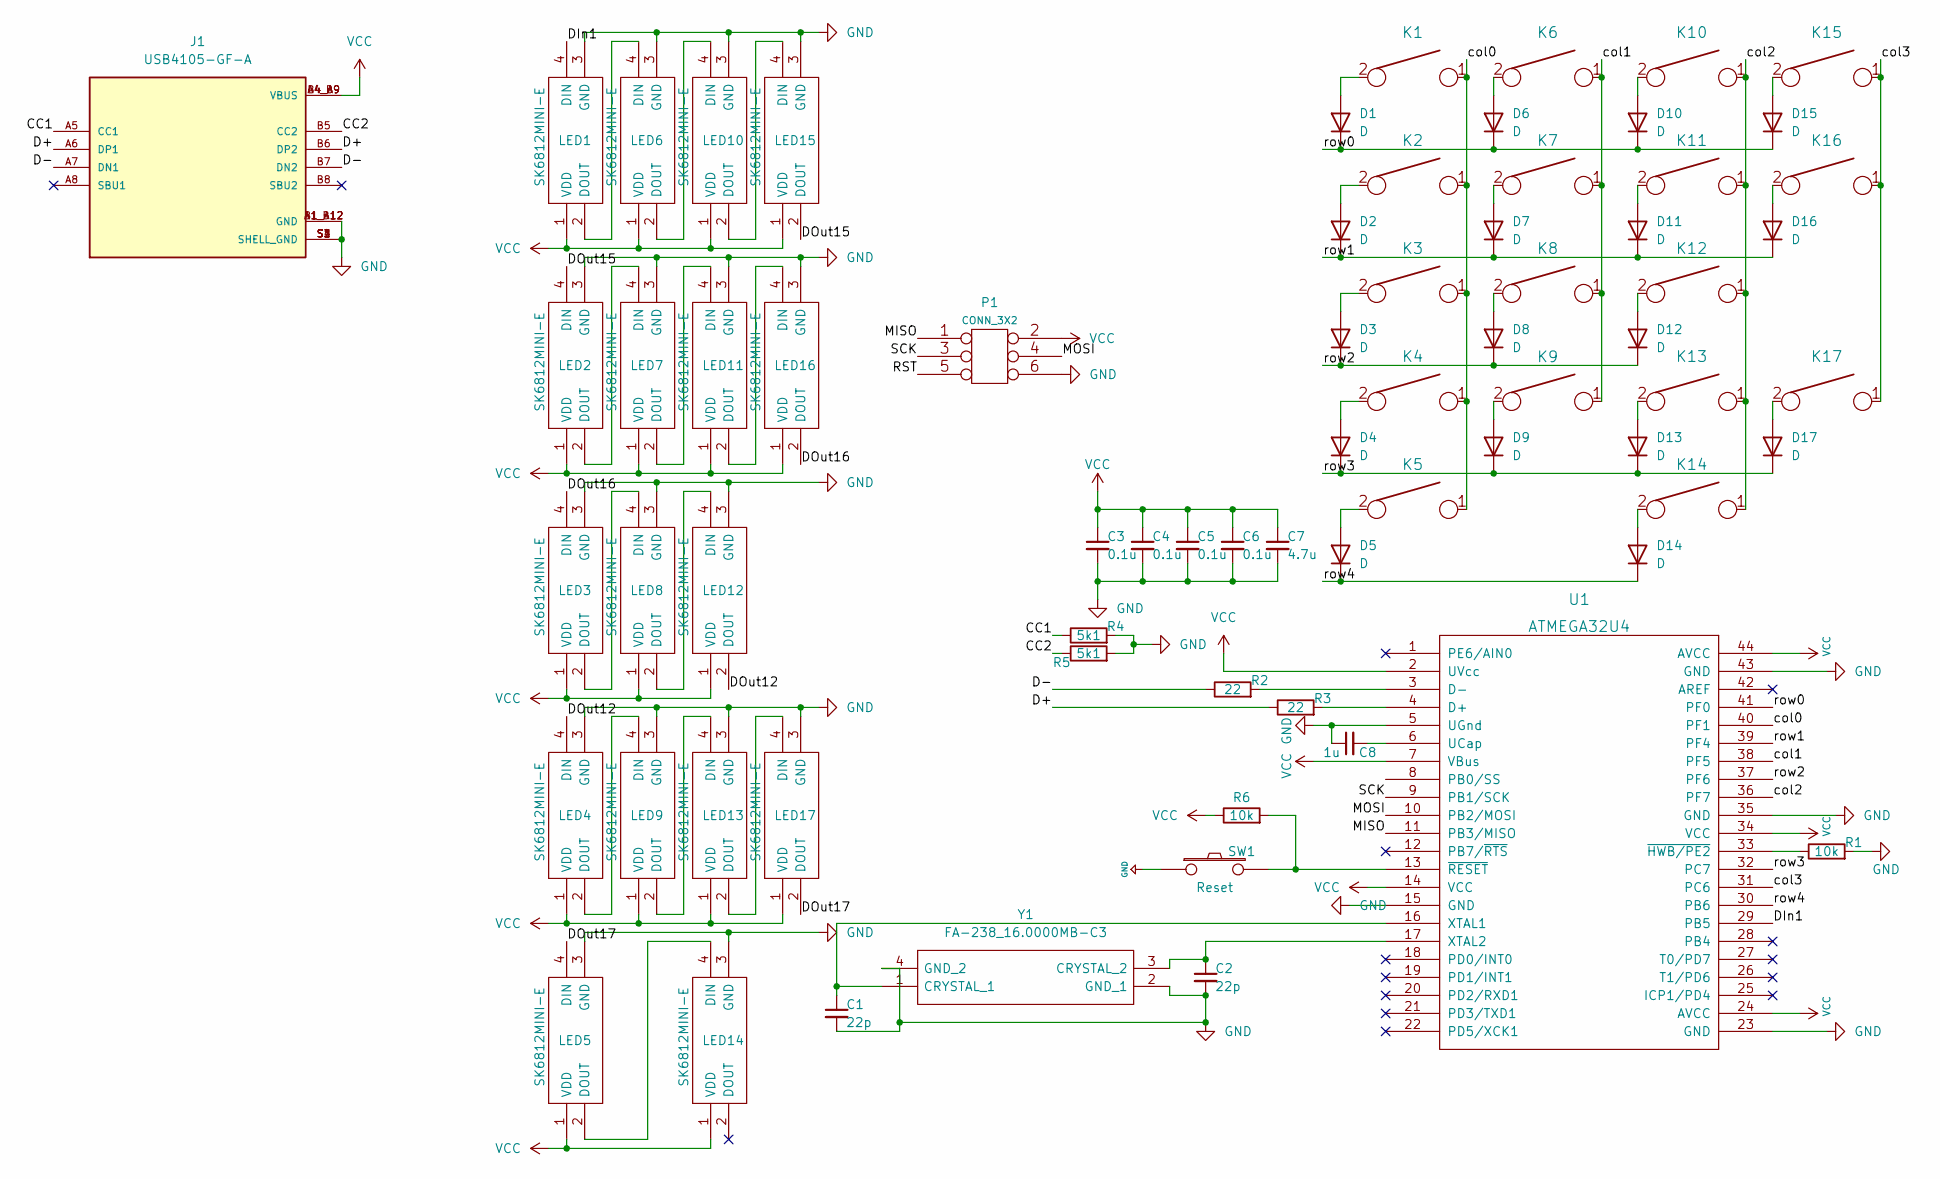
[picture p18: schematic Ramen Pad.kicad_sch]

Parts:
C1, C2: 22p; C_0805_2012Metric_Pad1.18x1.45mm_HandSolder
C3, C4, C5, C6: 0.1u; C_0805_2012Metric_Pad1.18x1.45mm_HandSolder
C7: 4.7u; C_0805_2012Metric_Pad1.18x1.45mm_HandSolder
C8: 1u; C_0805_2012Metric_Pad1.18x1.45mm_HandSolder
D1, D2, D3, D4, D5, D6, D7, D8, D9, D10, D11, D12, D13, D14, D15, D16, D17: D; D_SOD123_axial
J1: USB4105-GF-A; GCT_USB4105-GF-A; PARTREV A3
K1, K2, K3, K4, K5, K6, K7, K8, K9, K10, K11, K12, K13, K14, K15, K16, K17: KEYSW; Kailh_socket_MX_platemount
LED1, LED2, LED3, LED4, LED5, LED6, LED7, LED8, LED9, LED10, LED11, LED12, LED13, LED14, LED15, LED16, LED17: SK6812MINI-E; SK6812-MINI-E; Manufacturer_Part_Number SK6812MINI-E
P1: CONN_3X2; PinSocket_1x06_P1.00mm_Vertical
R1, R6: 10k; R_0805_2012Metric_Pad1.20x1.40mm_HandSolder
R2, R3: 22; R_0805_2012Metric_Pad1.20x1.40mm_HandSolder
R4, R5: 5k1; R_0805_2012Metric_Pad1.20x1.40mm_HandSolder
SW1: Reset; SW_SPST_TL3342
U1: ATMEGA32U4; TQFP-44_10x10mm_P0.8mm
Y1: FA-238_16.0000MB-C3; FA238160000MBC3; Manufacturer_Part_Number FA-238 16.0000MB-C3; Mouser Part Number 732-FA-23816B-C3

Connections:
/CC1: J1.A5 (CC1), R4.1
/CC2: J1.B5 (CC2), R5.1
/D+: J1.A6 (DP1), J1.B6 (DP2), R3.1
/D-: J1.A7 (DN1), J1.B7 (DN2), R2.1
/DIn1: LED1.4 (DIN), U1.29 (PB5)
/DOut12: LED4.4 (DIN), LED12.2 (DOUT)
/DOut15: LED2.4 (DIN), LED15.2 (DOUT)
/DOut16: LED3.4 (DIN), LED16.2 (DOUT)
/DOut17: LED5.4 (DIN), LED17.2 (DOUT)
/MISO: P1.1, U1.11 (PB3/MISO)
/MOSI: P1.4, U1.10 (PB2/MOSI)
/RST: P1.5
/SCK: P1.3, U1.9 (PB1/SCK)
/col0: K1.1, K2.1, K3.1, K4.1, K5.1, U1.40 (PF1)
/col1: K6.1, K7.1, K8.1, K9.1, U1.38 (PF5)
/col2: K10.1, K11.1, K12.1, K13.1, K14.1, U1.36 (PF7)
/col3: K15.1, K16.1, K17.1, U1.31 (PC6)
/row0: D1.1 (K), D6.1 (K), D10.1 (K), D15.1 (K), U1.41 (PF0)
/row1: D2.1 (K), D7.1 (K), D11.1 (K), D16.1 (K), U1.39 (PF4)
/row2: D3.1 (K), D8.1 (K), D12.1 (K), U1.37 (PF6)
/row3: D4.1 (K), D9.1 (K), D13.1 (K), D17.1 (K), U1.32 (PC7)
/row4: D5.1 (K), D14.1 (K), U1.30 (PB6)
unnamed: C1.1, U1.16 (XTAL1), Y1.1 (CRYSTAL_1)
unnamed: C2.1, U1.17 (XTAL2), Y1.3 (CRYSTAL_2)
unnamed: C8.2, U1.6 (UCap)
unnamed: D1.2 (A), K1.2
unnamed: D2.2 (A), K2.2
unnamed: D3.2 (A), K3.2
unnamed: D4.2 (A), K4.2
unnamed: D5.2 (A), K5.2
unnamed: D6.2 (A), K6.2
unnamed: D7.2 (A), K7.2
unnamed: D8.2 (A), K8.2
unnamed: D9.2 (A), K9.2
unnamed: D10.2 (A), K10.2
unnamed: D11.2 (A), K11.2
unnamed: D12.2 (A), K12.2
unnamed: D13.2 (A), K13.2
unnamed: D14.2 (A), K14.2
unnamed: D15.2 (A), K15.2
unnamed: D16.2 (A), K16.2
unnamed: D17.2 (A), K17.2
unnamed: LED1.2 (DOUT), LED6.4 (DIN)
unnamed: LED2.2 (DOUT), LED7.4 (DIN)
unnamed: LED3.2 (DOUT), LED8.4 (DIN)
unnamed: LED4.2 (DOUT), LED9.4 (DIN)
unnamed: LED10.2 (DOUT), LED15.4 (DIN)
unnamed: LED6.2 (DOUT), LED10.4 (DIN)
unnamed: LED11.2 (DOUT), LED16.4 (DIN)
unnamed: LED7.2 (DOUT), LED11.4 (DIN)
unnamed: LED8.2 (DOUT), LED12.4 (DIN)
unnamed: LED13.2 (DOUT), LED17.4 (DIN)
unnamed: LED9.2 (DOUT), LED13.4 (DIN)
unnamed: LED5.2 (DOUT), LED14.4 (DIN)
unnamed: R1.1, U1.33 (~HWB/PE2)
unnamed: R2.2, U1.3 (D-)
unnamed: R3.2, U1.4 (D+)
unnamed: R6.2, SW1.2, U1.13 (~RESET)
VCC: C3.1, C4.1, C5.1, C6.1, C7.1, J1.A4_B9 (VBUS), J1.B4_A9 (VBUS), LED1.1 (VDD), LED2.1 (VDD), LED3.1 (VDD), LED4.1 (VDD), LED5.1 (VDD), LED6.1 (VDD), LED7.1 (VDD), LED8.1 (VDD), LED9.1 (VDD), LED10.1 (VDD), LED11.1 (VDD), LED12.1 (VDD), LED13.1 (VDD), LED14.1 (VDD), LED15.1 (VDD), LED16.1 (VDD), LED17.1 (VDD), P1.2, R6.1, U1.2 (UVcc), U1.7 (VBus), U1.14 (VCC), U1.24 (AVCC), U1.34 (VCC), U1.44 (AVCC)

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
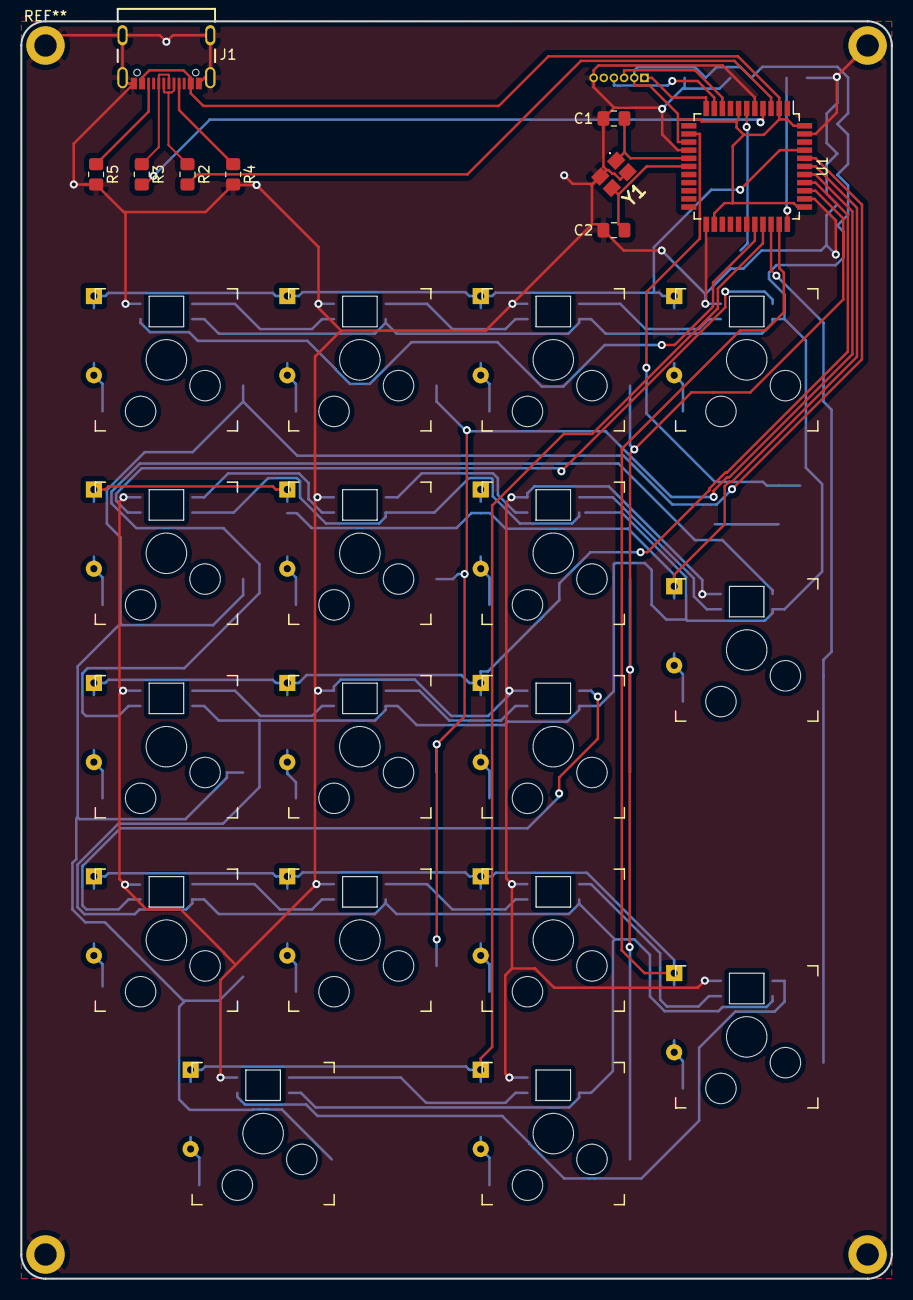
[picture p19: board Ramen Pad.kicad_pcb from above]

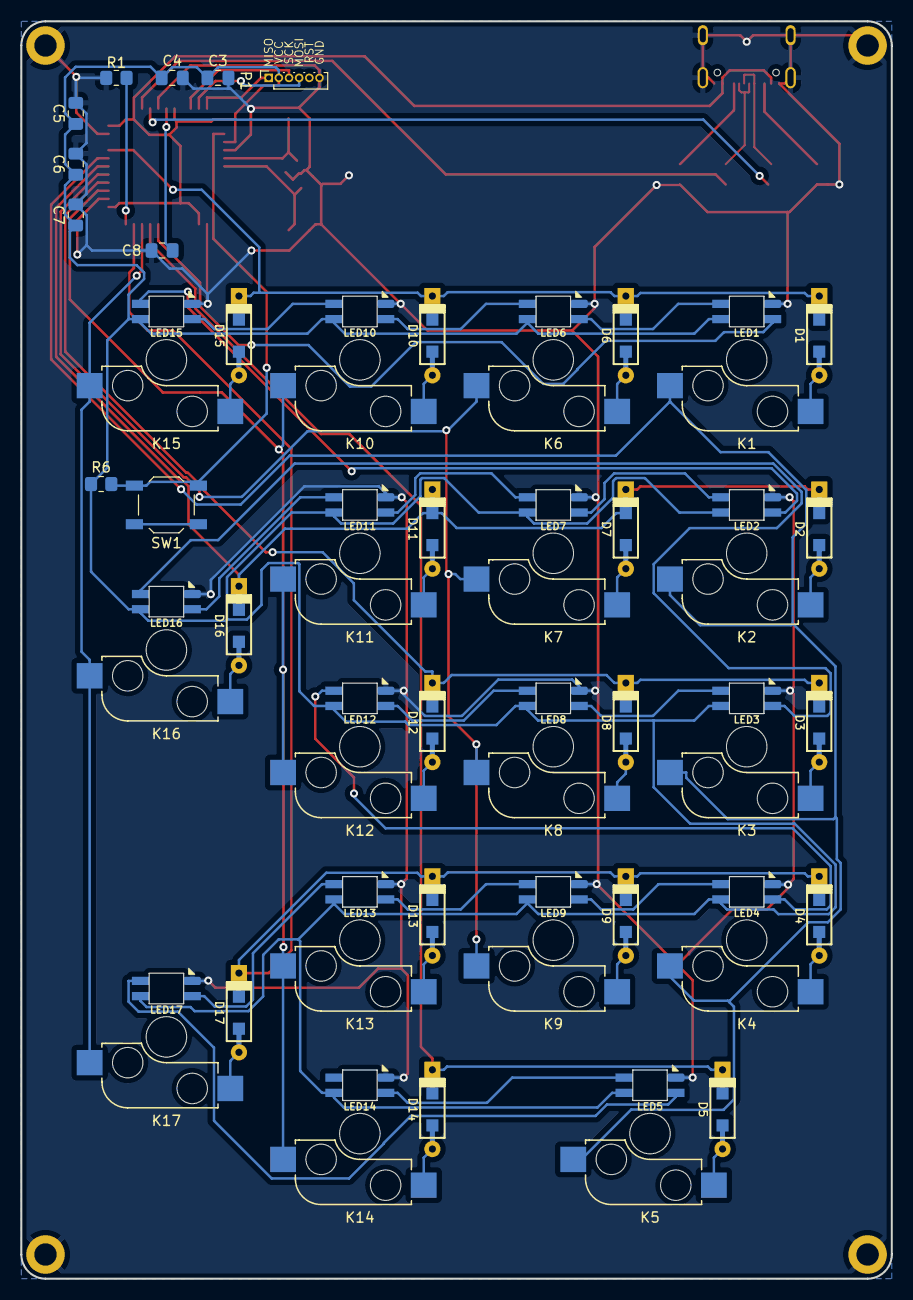
[picture p20: board Ramen Pad.kicad_pcb from below]

Board: 2 copper layers, 85.7 x 123.8 mm, 71 parts (44 on the bottom side), 59 nets.

Other parts of the board:
Ramen Pad: LOGO; RamenLogo
