Ramen5914/KiCadFiles/projects/Ramen80/ramen80.yaml

name: Ramen80  # Put the name of diagram here
description: Full PCB diagram for the Ramen Keebs 80% keyboard # Put a short description of the diagram here
components:
    C1:
        description: 0.47f  # Arbitrary comment
        groups: [] # Specify component groups
        pins:
            '1':  # Connected to VCC
                name: C1.1
                description: ''
                groups: []
            '2': # Connected to GND
                name: C1.2
                description: ''
                groups: []
        highlight: true # Make the component active
    C10:
        description: 0.47f  # Arbitrary comment
        groups: [] # Specify component groups
        pins:
            '1':  # Connected to VCC
                name: C10.1
                description: ''
                groups: []
            '2': # Connected to GND
                name: C10.2
                description: ''
                groups: []
        highlight: true # Make the component active
    C11:
        description: 0.47f  # Arbitrary comment
        groups: [] # Specify component groups
        pins:
            '1':  # Connected to VCC
                name: C11.1
                description: ''
                groups: []
            '2': # Connected to GND
                name: C11.2
                description: ''
                groups: []
        highlight: true # Make the component active
    C12:
        description: 0.1f  # Arbitrary comment
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
        highlight: true # Make the component active
    D9:
        description: D  # Arbitrary comment
        groups: [] # Specify component groups
        pins:
            '1':  # Connected to /PF7
                name: D9.1
                description: ''
                groups: []
            '2': # Connected to Net-(D9-Pad2)
                name: D9.2
                description: ''
                groups: []
        highlight: true # Make the component active
    J1:
        description: 6 Pin AVR  # Arbitrary comment
        groups: [] # Specify component groups
        pins:
            '1':  # Connected to /PB3
                name: J1.1
                description: ''
                groups: []
            '2': # Connected to VCC
                name: J1.2
                description: ''
                groups: []
            '3': # Connected to /PB1
                name: J1.3
                description: ''
                groups: []
            '4': # Connected to /PB2
                name: J1.4
                description: ''
                groups: []
            '5': # Connected to /Reset
                name: J1.5
                description: ''
                groups: []
            '6': # Connected to GND
                name: J1.6
                description: ''
                groups: []
        highlight: true # Make the component active
    J2:
        description: USB4505-03-0-A  # Arbitrary comment
        groups: [] # Specify component groups
        pins:
            A1_B12:  # Connected to unconnected-(J2-PadA1_B12)
                name: J2.A1_B12
                description: ''
                groups: []
            A4_B9: # Connected to VCC
                name: J2.A4_B9
                description: ''
                groups: []
            A5: # Connected to Net-(J2-PadA5)
                name: J2.A5
                description: ''
                groups: []
            A6: # Connected to /USB C Receptacle/Cap+
                name: J2.A6
                description: ''
                groups: []
            A7: # Connected to /USB C Receptacle/Cap-
                name: J2.A7
                description: ''
                groups: []
            A8: # Connected to unconnected-(J2-PadA8)
                name: J2.A8
                description: ''
                groups: []
            B1_A12: # Connected to GND
                name: J2.B1_A12
                description: ''
                groups: []
            B4_A9: # Connected to VCC
                name: J2.B4_A9
                description: ''
                groups: []
            B5: # Connected to Net-(J2-PadB5)
                name: J2.B5
                description: ''
                groups: []
            B6: # Connected to /USB C Receptacle/Cap+
                name: J2.B6
                description: ''
                groups: []
            B7: # Connected to /USB C Receptacle/Cap-
                name: J2.B7
                description: ''
                groups: []
            B8: # Connected to unconnected-(J2-PadB8)
                name: J2.B8
                description: ''
                groups: []
            S1: # Connected to GND
                name: J2.S1
                description: ''
                groups: []
            S2: # Connected to GND
                name: J2.S2
                description: ''
                groups: []
            S3: # Connected to GND
                name: J2.S3
                description: ''
                groups: []
            S4: # Connected to GND
                name: J2.S4
                description: ''
                groups: []
        highlight: true # Make the component active
    K1:
        description: KEYSW  # Arbitrary comment
        groups: [] # Specify component groups
        pins:
            '':  # Connected to 
                name: K1.
                description: ''
                groups: []
            '1': # Connected to /PE6
                name: K1.1
                description: ''
                groups: []
            '2': # Connected to Net-(D1-Pad2)
                name: K1.2
                description: ''
                groups: []
        highlight: true # Make the component active
    K10:
        description: KEYSW  # Arbitrary comment
        groups: [] # Specify component groups
        pins:
            '':  # Connected to 
                name: K10.
                description: ''
                groups: []
            '1': # Connected to /PD7
                name: K10.1
                description: ''
                groups: []
            '2': # Connected to Net-(D10-Pad2)
                name: K10.2
                description: ''
                groups: []
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
        groups: [] # Specify component groups
        pins:
            '1':  # Connected to /LED Matrix/SW6
                name: LED35.1
                description: ''
                groups: []
            '2': # Connected to /LED Matrix/SW4
                name: LED35.2
                description: ''
                groups: []
            '3': # Connected to /LED Matrix/SW5
                name: LED35.3
                description: ''
                groups: []
            '4': # Connected to /LED Matrix/CS2
                name: LED35.4
                description: ''
                groups: []
        highlight: true # Make the component active
    LED36:
        description: RGB_LED  # Arbitrary comment
        groups: [] # Specify component groups
        pins:
            '1':  # Connected to /LED Matrix/SW6
                name: LED36.1
                description: ''
                groups: []
            '2': # Connected to /LED Matrix/SW4
                name: LED36.2
                description: ''
                groups: []
            '3': # Connected to /LED Matrix/SW5
                name: LED36.3
                description: ''
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
