Ramen5914/KiCadFiles/(commit log)

2022-02-28 Added KiCad Directory
    [Micro_Commercial_Components_-_1N4448W-TP.step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]
2022-02-28 Updated PCB
2022-02-28 PCB Update
    [Ramen Board.dsn, Ramen Pad.kicad_pcb]
2022-03-02 Fixing the broke stuff
    [Ramen Board.dsn, Ramen80(Avr Prorgrammer).kicad_sch, Ramen80(Capacitor Grid).kicad_sch, Ramen80(Clock Crystal).kicad_sch, Ramen80(Led Matrix).kicad_sch, Ramen80(Reset Switch).kicad_sch, Ramen80(Resistor Grid).kicad_sch, Ramen80.kicad_sch]
2022-03-02 Fixes continue...
    [Ramen80(Capacitor Grid).kicad_sch, Ramen80(Led Matrix).kicad_sch, Ramen80(Resistor Grid).kicad_sch]
2022-03-02 Added GND Layer Zone
    [Ramen Board.dsn]
2022-03-03 Fixes (re-mapped pinout)
    [Ramen80(Led Matrix).kicad_sch, Ramen80.kicad_sch]
2022-03-03 Changes RGB LED Footprint
    Added triangle on silkscreen layer to indicate pin 1 of the RGB LED
2022-03-03 Cleaned up PCB tracks
2022-03-03 Final Fixes
    [Ramen Board.dsn, Ramen80(Led Matrix).kicad_sch]
2022-03-03 Reverted Pin Out Changes
    [Ramen80(Led Matrix).kicad_sch]
2022-03-03 Reverted Changes to LED Matrix Pin outs
    [Ramen Board.dsn]
2022-03-05 Latest Full PCB
2022-03-05 Added Spectra DSN and Spectra Session
    [Ramen Board.dsn]
2022-03-05 Finished Traces
2022-03-06 Finished PCB
    [ATMEGA32U4-AUR.step, D_AXIAL.step, KAILH_PLATEMOUNT.step, QBLP677R-RGB.step, Ramen Board.dsn, Ramen80(Avr Prorgrammer).kicad_sch, Ramen80(Capacitor Grid).kicad_sch, Ramen80(Clock Crystal).kicad_sch]
2022-03-06 Fixed all clearance violations
    [Ramen80.kicad_pcb]
2022-03-07 Created Gerber Files
    [Ramen80(Capacitor Grid).kicad_sch, Ramen80(Clock Crystal).kicad_sch, Ramen80(Led Matrix).kicad_sch, Ramen80(Resistor Grid).kicad_sch, Ramen80(Usb C Receptacle).kicad_sch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]
