Ramen5914/KiCadFiles/(notices)

Notices in the files:
3dmodels/RamenKeebs.models/USB4505-03-0-A.stp:
FILE_NAME( 'p:/temp/worker_53/temp/exporttempdir_3656_370_7hz5i/format_0/USB4505-03-0-A.stp', '2022-03-05T23:24:30', ( 'License CC BY-ND 4.0' ), ( 'CADENAS' ), ' ', 'PARTsolutions', ' ' );
